FTBF/SquarePad-anode-capactive-readout/(list of files, cad)

Other CAD files:
Design2_TwoBoardPogoPin/Sch_ALL.dwg
