FTBF/SquarePad-anode-capactive-readout/Design1_SignleBoard/fab_instructions_square.docx

Fabrication notes for pad_64_in

(Square Anodes version 2)

Designer contact: Jacky Li, jackymengyangli@uchicago.edu

Board stack info: 6-layer board, 6 mm board,

The layers are organized as

i. Cu_F ---- Signal (L1)
ii. Cu_ln1 ----Ground (L2)
iii. Cu_ln2 (empty plane) ---- Ground (L3)
iv. Cu_ln3 ---- Ground (L4)
v. Cu_ln4 ---- Signal (L5)
vi. Cu_B ---- Ground (L6)

We have traces on Cu_F and Cu_ln4, they need to be 50 ohms impedance, including vias that connect the traces between these planes.

For traces on Cu_F, now you can couple it to Cu_ln1 to make it 50 ohms. Please make the distances between Cu_F and Cu_ln3 as far as possible.

I have adjusted the width of the vias, now they are >0.7mm.
