FTBF/SquarePad-anode-capactive-readout/Design2_TwoBoardPogoPin/Board1 - Pad and Pogo Pin/fab_instructions_Board1.docx

## Fabrication notes for <Board 1 – Pad and Pogo Pin>

Designer contact: Jacky Li, jackymengyangli@uchicago.edu

Board Stack Info: 2 layer board, 1.6 mm thickness, 1/1 oz Cu. Size 9.65 * 11.79 in.

No impedance control needed on this board.
