FTBF/SquarePad-anode-capactive-readout/Design2_TwoBoardPogoPin/Board2 - Housing and Samtech/fab_instructions_Board2.docx

## Fabrication notes for <Board 2 – Housing and Samtech>

Designer contact: Jacky Li, jackymengyangli@uchicago.edu

Board Stack Info: 4 layer board, 1.6 mm thickness, 1/1 oz Cu. Size 9.65 * 11.79 in.

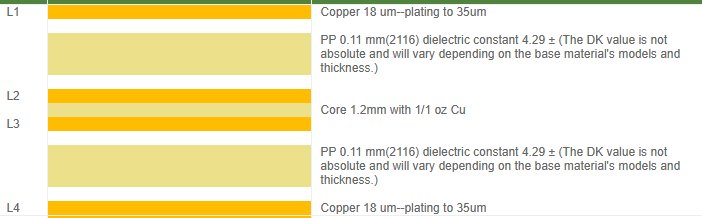
[picture p5: figure]

There are traces on L4, they couple to L3. We want impedance control on these to be 50 ohms.
