FTBF/SquarePad-anode-capactive-readout/Design2_TwoBoardPogoPin/Board1 - Pad and Pogo Pin/Kicad Files/Board1_Pad_PogoPin.kicad_pcb

## KiCad design Design2_TwoBoardPogoPin/Board1 - Pad and Pogo Pin/Kicad Files/Board1_Pad_PogoPin.kicad_pcb (2023-05-22)

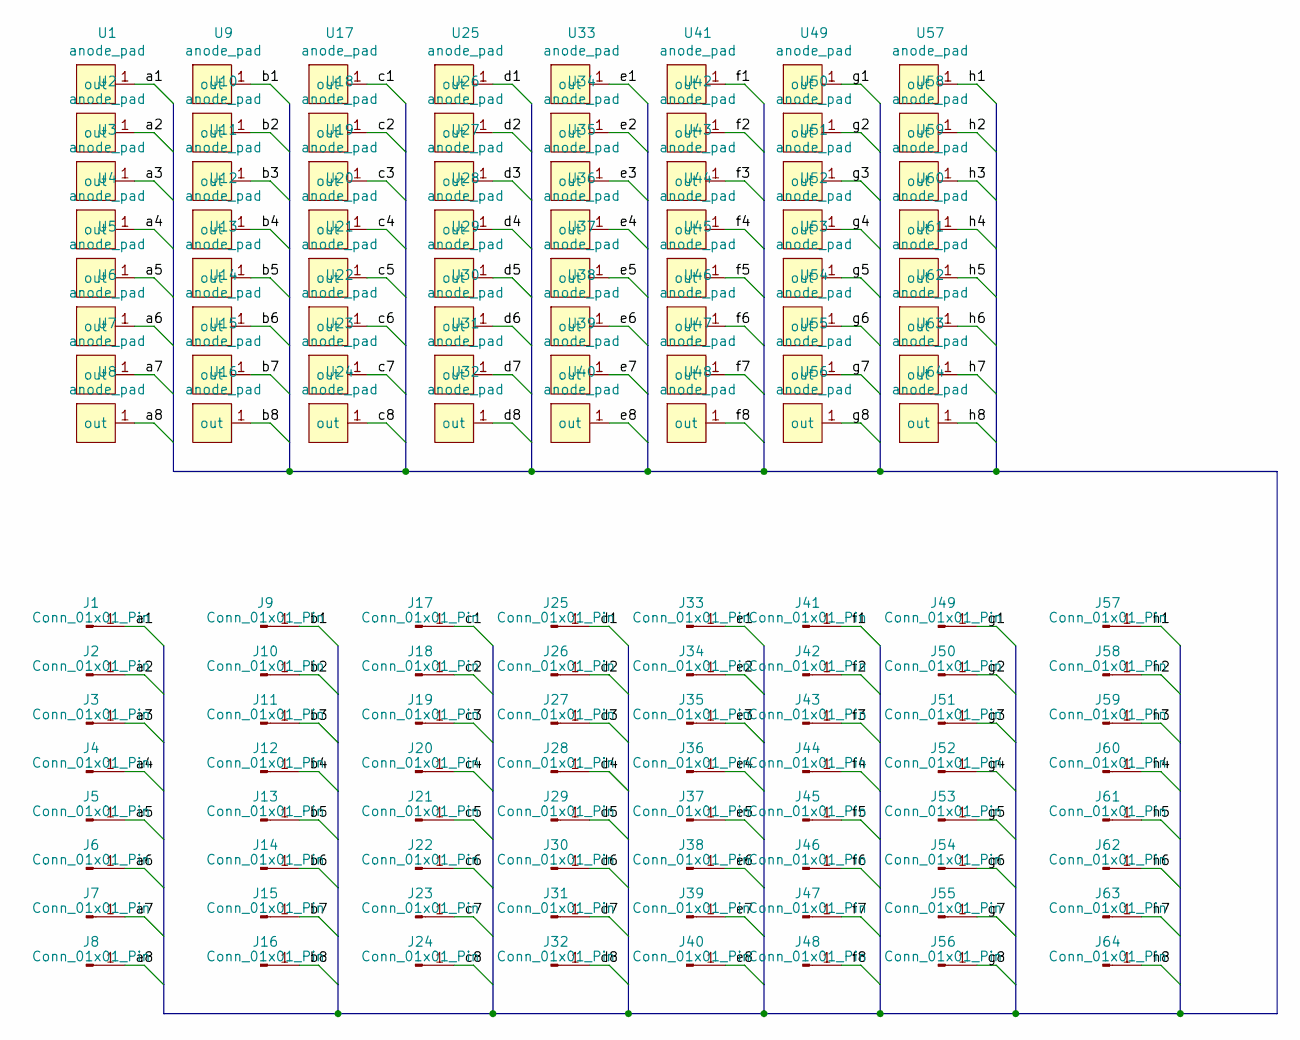
[picture p6: schematic Board1_Pad_PogoPin.kicad_sch]

Parts:
J1, J2, J3, J4, J5, J6, J7, J8, J9, J10, J11, J12, J13, J14, J15, J16, J17, J18, J19, J20, J21, J22, J23, J24, J25, J26, J27, J28, J29, J30, J31, J32, J33, J34, J35, J36, J37, J38, J39, J40, J41, J42, J43, J44, J45, J46, J47, J48, J49, J50, J51, J52, J53, J54, J55, J56, J57, J58, J59, J60, J61, J62, J63, J64: Conn_01x01_Pin; PogoPinWithTail
U1, U2, U3, U4, U5, U6, U7, U8, U9, U10, U11, U12, U13, U14, U15, U16, U17, U18, U19, U20, U21, U22, U23, U24, U25, U26, U27, U28, U29, U30, U31, U32, U33, U34, U35, U36, U37, U38, U39, U40, U41, U42, U43, U44, U45, U46, U47, U48, U49, U50, U51, U52, U53, U54, U55, U56, U57, U58, U59, U60, U61, U62, U63, U64: anode_pad; anode_square_pad_no_hole

Connections:
/a1: J1.1, U1.1 (out)
/a2: J2.1, U2.1 (out)
/a3: J3.1, U3.1 (out)
/a4: J4.1, U4.1 (out)
/a5: J5.1, U5.1 (out)
/a6: J6.1, U6.1 (out)
/a7: J7.1, U7.1 (out)
/a8: J8.1, U8.1 (out)
/b1: J9.1, U9.1 (out)
/b2: J10.1, U10.1 (out)
/b3: J11.1, U11.1 (out)
/b4: J12.1, U12.1 (out)
/b5: J13.1, U13.1 (out)
/b6: J14.1, U14.1 (out)
/b7: J15.1, U15.1 (out)
/b8: J16.1, U16.1 (out)
/c1: J17.1, U17.1 (out)
/c2: J18.1, U18.1 (out)
/c3: J19.1, U19.1 (out)
/c4: J20.1, U20.1 (out)
/c5: J21.1, U21.1 (out)
/c6: J22.1, U22.1 (out)
/c7: J23.1, U23.1 (out)
/c8: J24.1, U24.1 (out)
/d1: J25.1, U25.1 (out)
/d2: J26.1, U26.1 (out)
/d3: J27.1, U27.1 (out)
/d4: J28.1, U28.1 (out)
/d5: J29.1, U29.1 (out)
/d6: J30.1, U30.1 (out)
/d7: J31.1, U31.1 (out)
/d8: J32.1, U32.1 (out)
/e1: J33.1, U33.1 (out)
/e2: J34.1, U34.1 (out)
/e3: J35.1, U35.1 (out)
/e4: J36.1, U36.1 (out)
/e5: J37.1, U37.1 (out)
/e6: J38.1, U38.1 (out)
/e7: J39.1, U39.1 (out)
/e8: J40.1, U40.1 (out)
/f1: J41.1, U41.1 (out)
/f2: J42.1, U42.1 (out)
/f3: J43.1, U43.1 (out)
/f4: J44.1, U44.1 (out)
/f5: J45.1, U45.1 (out)
/f6: J46.1, U46.1 (out)
/f7: J47.1, U47.1 (out)
/f8: J48.1, U48.1 (out)
/g1: J49.1, U49.1 (out)
/g2: J50.1, U50.1 (out)
/g3: J51.1, U51.1 (out)
/g4: J52.1, U52.1 (out)
/g5: J53.1, U53.1 (out)
/g6: J54.1, U54.1 (out)
/g7: J55.1, U55.1 (out)
/g8: J56.1, U56.1 (out)
/h1: J57.1, U57.1 (out)
/h2: J58.1, U58.1 (out)
/h3: J59.1, U59.1 (out)
/h4: J60.1, U60.1 (out)
/h5: J61.1, U61.1 (out)
/h6: J62.1, U62.1 (out)
/h7: J63.1, U63.1 (out)
/h8: J64.1, U64.1 (out)

Board: 2 copper layers, 128 parts (64 on the bottom side), 64 nets, no tracks yet.
