FTBF/SquarePad-anode-capactive-readout/Design1_SignleBoard/kicad_project/pad_64in.kicad_pcb

## KiCad design Design1_SignleBoard/kicad_project/pad_64in.kicad_pcb (2023-03-02)

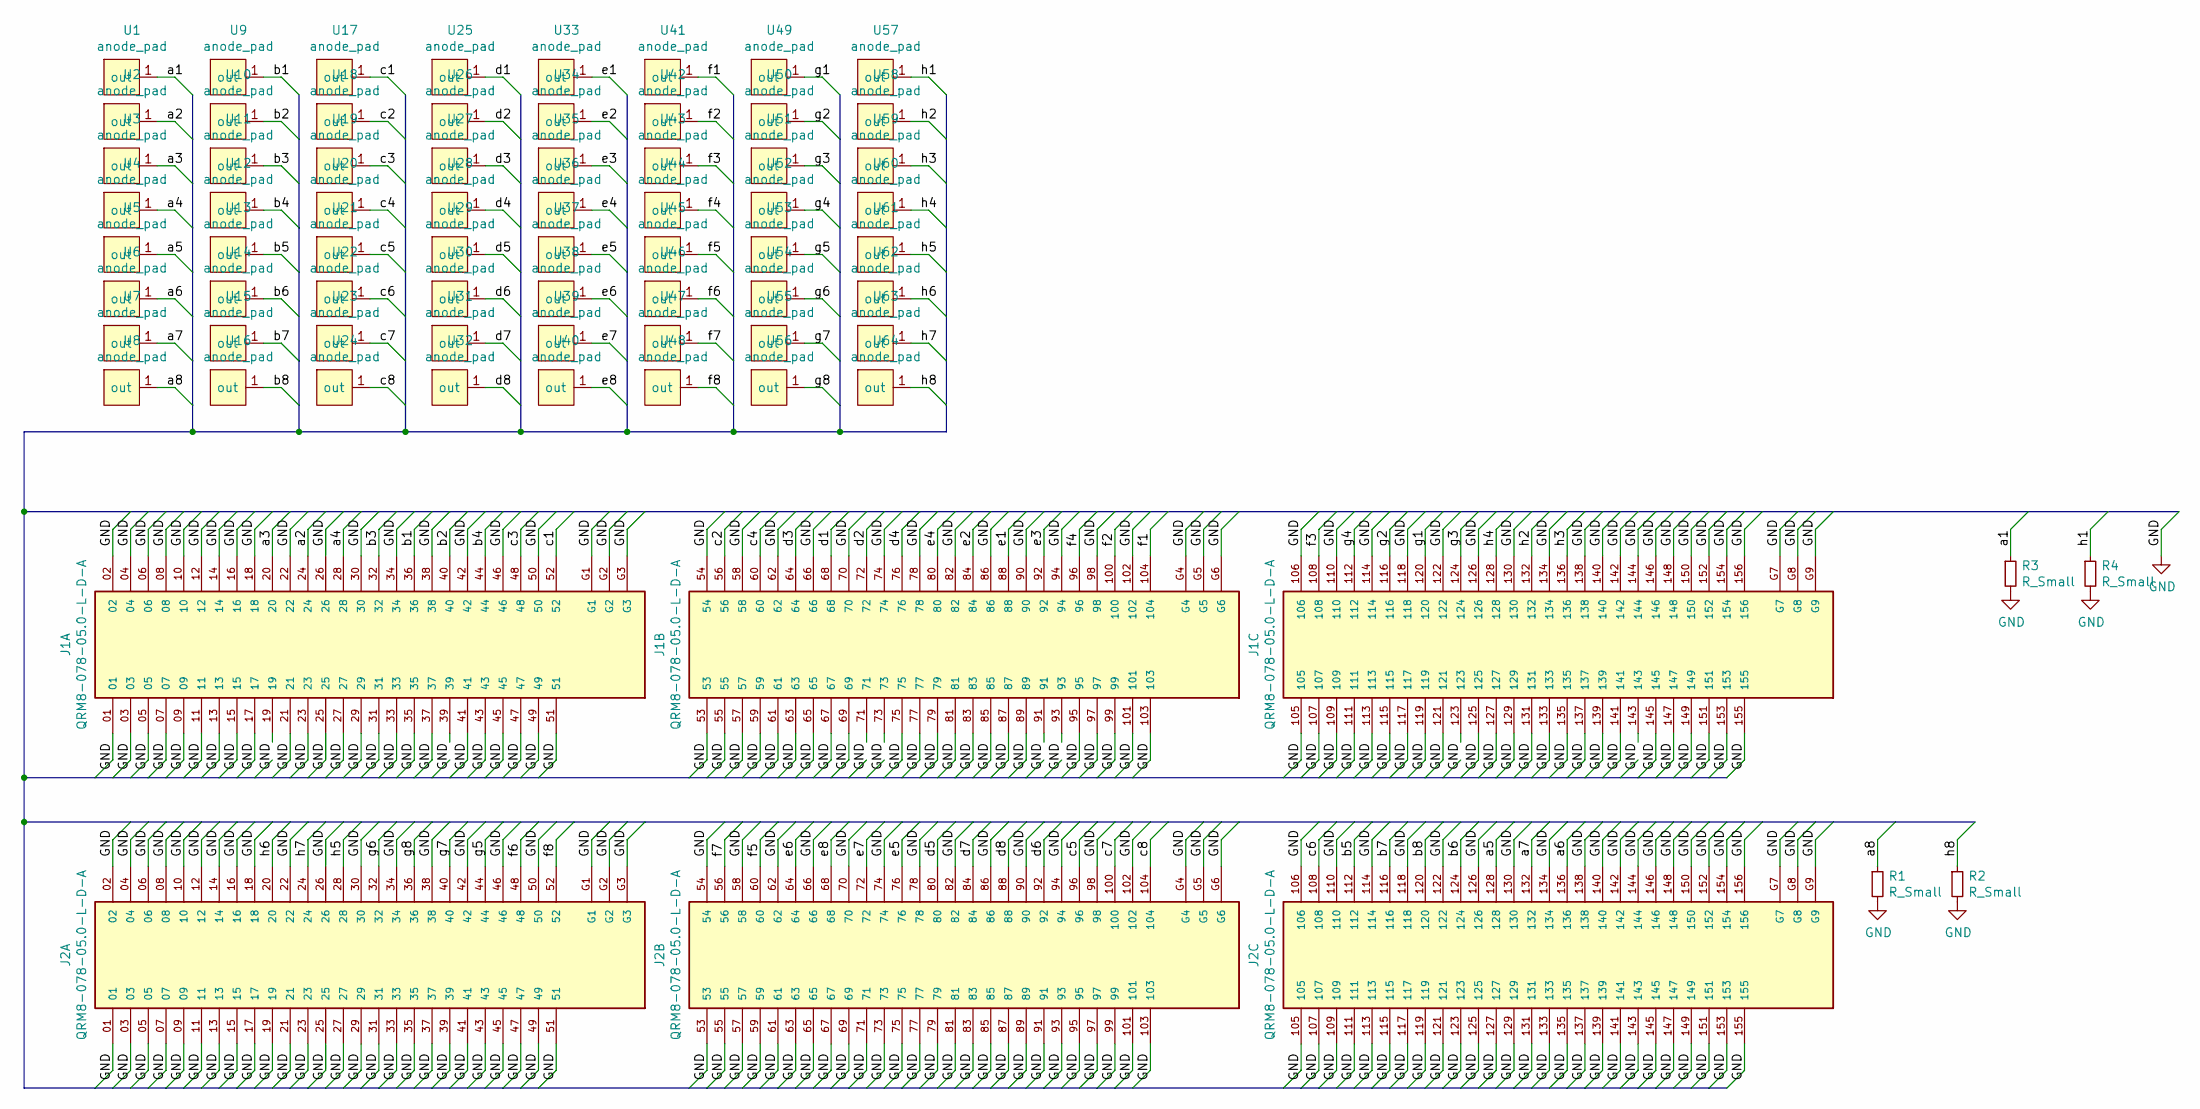
[picture p10: schematic pad_64in.kicad_sch]

Parts:
J1, J2: QRM8-078-05.0-L-D-A; SAMTEC_QRM8-078-05.0-L-D-A
R1, R2, R3, R4: R_Small; R_0805_2012Metric_Pad1.15x1.40mm_HandSolder
U1, U2, U3, U4, U5, U6, U7, U8, U9, U10, U11, U12, U13, U14, U15, U16, U17, U18, U19, U20, U21, U22, U23, U24, U25, U26, U27, U28, U29, U30, U31, U32, U33, U34, U35, U36, U37, U38, U39, U40, U41, U42, U43, U44, U45, U46, U47, U48, U49, U50, U51, U52, U53, U54, U55, U56, U57, U58, U59, U60, U61, U62, U63, U64: anode_pad; anode_square_pad

Connections:
/a1: R3.1, U1.1
/a2: J1.24, U2.1
/a3: J1.20, U3.1
/a4: J1.28, U4.1
/a5: J2.128, U5.1
/a6: J2.136, U6.1
/a7: J2.132, U7.1
/a8: R1.1, U8.1
/b1: J1.36, U9.1
/b2: J1.40, U10.1
/b3: J1.32, U11.1
/b4: J1.44, U12.1
/b5: J2.112, U13.1
/b6: J2.124, U14.1
/b7: J2.116, U15.1
/b8: J2.120, U16.1
/c1: J1.52, U17.1
/c2: J1.56, U18.1
/c3: J1.48, U19.1
/c4: J1.60, U20.1
/c5: J2.96, U21.1
/c6: J2.108, U22.1
/c7: J2.100, U23.1
/c8: J2.104, U24.1
/d1: J1.68, U25.1
/d2: J1.72, U26.1
/d3: J1.64, U27.1
/d4: J1.76, U28.1
/d5: J2.80, U29.1
/d6: J2.92, U30.1
/d7: J2.84, U31.1
/d8: J2.88, U32.1
/e1: J1.88, U33.1
/e2: J1.84, U34.1
/e3: J1.92, U35.1
/e4: J1.80, U36.1
/e5: J2.76, U37.1
/e6: J2.64, U38.1
/e7: J2.72, U39.1
/e8: J2.68, U40.1
/f1: J1.104, U41.1
/f2: J1.100, U42.1
/f3: J1.108, U43.1
/f4: J1.96, U44.1
/f5: J2.60, U45.1
/f6: J2.48, U46.1
/f7: J2.56, U47.1
/f8: J2.52, U48.1
/g1: J1.120, U49.1
/g2: J1.116, U50.1
/g3: J1.124, U51.1
/g4: J1.112, U52.1
/g5: J2.44, U53.1
/g6: J2.32, U54.1
/g7: J2.40, U55.1
/g8: J2.36, U56.1
/h1: R4.1, U57.1
/h2: J1.132, U58.1
/h3: J1.136, U59.1
/h4: J1.128, U60.1
/h5: J2.28, U61.1
/h6: J2.20, U62.1
/h7: J2.24, U63.1
/h8: R2.1, U64.1
GND: J1.01, J1.02, J1.03, J1.04, J1.05, J1.06, J1.07, J1.08, J1.09, J1.10, J1.11, J1.12, J1.13, J1.14, J1.15, J1.16, J1.17, J1.18, J1.19, J1.21, J1.22, J1.23, J1.25, J1.26, J1.27, J1.29, J1.30, J1.31, J1.33, J1.34, J1.35, J1.37, J1.38, J1.39, J1.41, J1.42, J1.43, J1.45, J1.46, J1.47, J1.49, J1.50, J1.51, J1.53, J1.54, J1.55, J1.57, J1.58, J1.59, J1.61, J1.62, J1.63, J1.65, J1.66, J1.67, J1.69, J1.70, J1.71, J1.73, J1.74, J1.75, J1.77, J1.78, J1.79, J1.81, J1.82, J1.83, J1.85, J1.86, J1.87, J1.89, J1.90, J1.91, J1.93, J1.94, J1.95, J1.97, J1.98, J1.99, J1.101, J1.102, J1.103, J1.105, J1.106, J1.107, J1.109, J1.110, J1.111, J1.113, J1.114, J1.115, J1.117, J1.118, J1.119, J1.121, J1.122, J1.123, J1.125, J1.126, J1.127, J1.129, J1.130, J1.131, J1.133, J1.134, J1.135, J1.137, J1.138, J1.139, J1.140, J1.141, J1.142, J1.143, J1.144, J1.145, J1.146, J1.147, J1.148, J1.149, J1.150, J1.151, J1.152, J1.153, J1.154, J1.155, J1.156, J1.G1, J1.G2, J1.G3, J1.G4, J1.G5, J1.G6, J1.G7, J1.G8, J1.G9, J2.01, J2.02, J2.03, J2.04, J2.05, J2.06, J2.07, J2.08, J2.09, J2.10, J2.11, J2.12, J2.13, J2.14, J2.15, J2.16, J2.17, J2.18, J2.19, J2.21, J2.22, J2.23, J2.25, J2.26, J2.27, J2.29, J2.30, J2.31, J2.33, J2.34, J2.35, J2.37, J2.38, J2.39, J2.41, J2.42, J2.43, J2.45, J2.46, J2.47, J2.49, J2.50, J2.51, J2.53, J2.54, J2.55, J2.57, J2.58, J2.59, J2.61, J2.62, J2.63, J2.65, J2.66, J2.67, J2.69, J2.70, J2.71, J2.73, J2.74, J2.75, J2.77, J2.78, J2.79, J2.81, J2.82, J2.83, J2.85, J2.86, J2.87, J2.89, J2.90, J2.91, J2.93, J2.94, J2.95, J2.97, J2.98, J2.99, J2.101, J2.102, J2.103, J2.105, J2.106, J2.107, J2.109, J2.110, J2.111, J2.113, J2.114, J2.115, J2.117, J2.118, J2.119, J2.121, J2.122, J2.123, J2.125, J2.126, J2.127, J2.129, J2.130, J2.131, J2.133, J2.134, J2.135, J2.137, J2.138, J2.139, J2.140, J2.141, J2.142, J2.143, J2.144, J2.145, J2.146, J2.147, J2.148, J2.149, J2.150, J2.151, J2.152, J2.153, J2.154, J2.155, J2.156, J2.G1, J2.G2, J2.G3, J2.G4, J2.G5, J2.G6, J2.G7, J2.G8, J2.G9, R1.2, R2.2, R3.2, R4.2

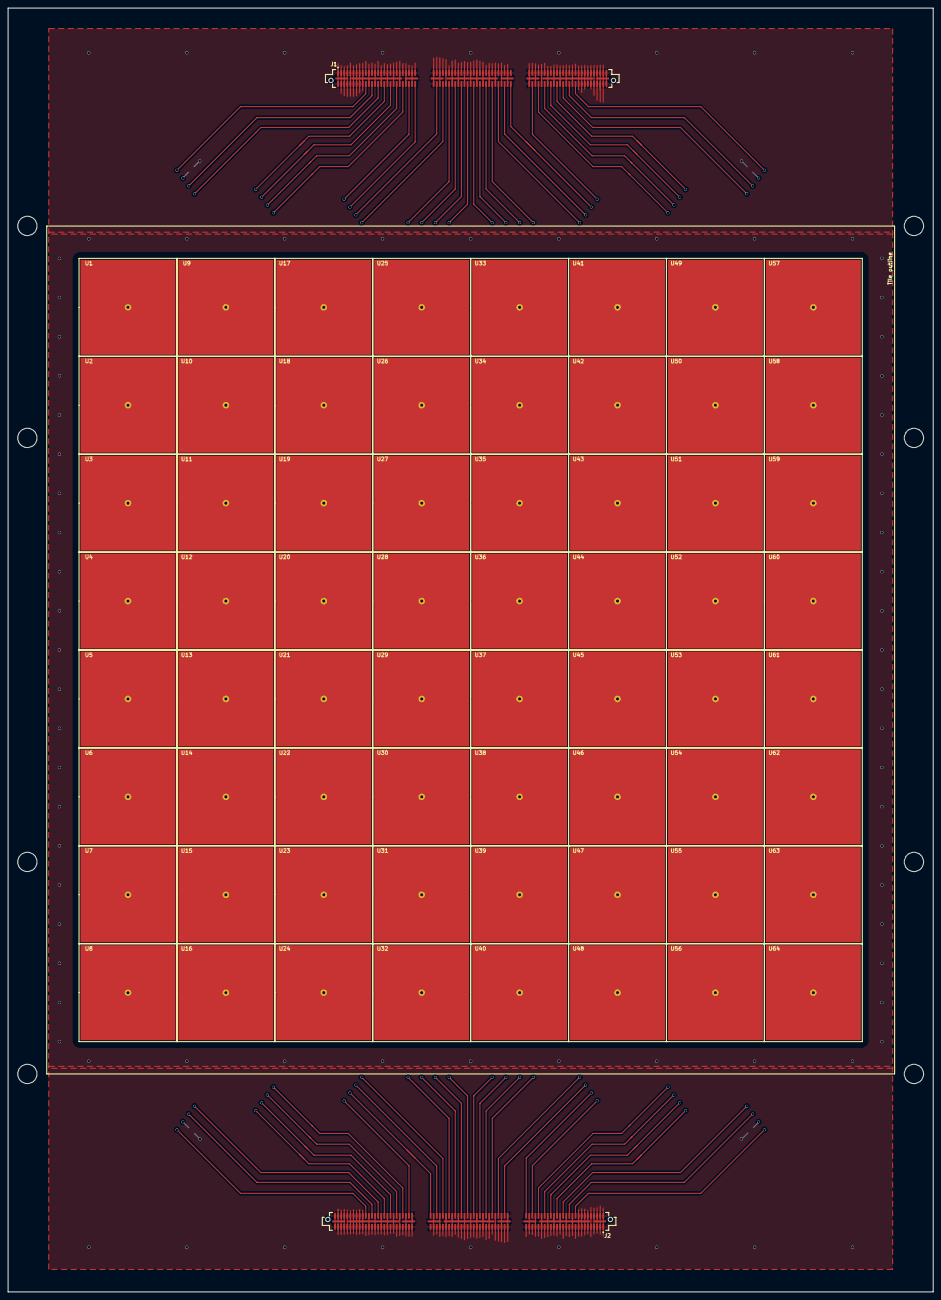
[picture p11: board pad_64in.kicad_pcb from above]

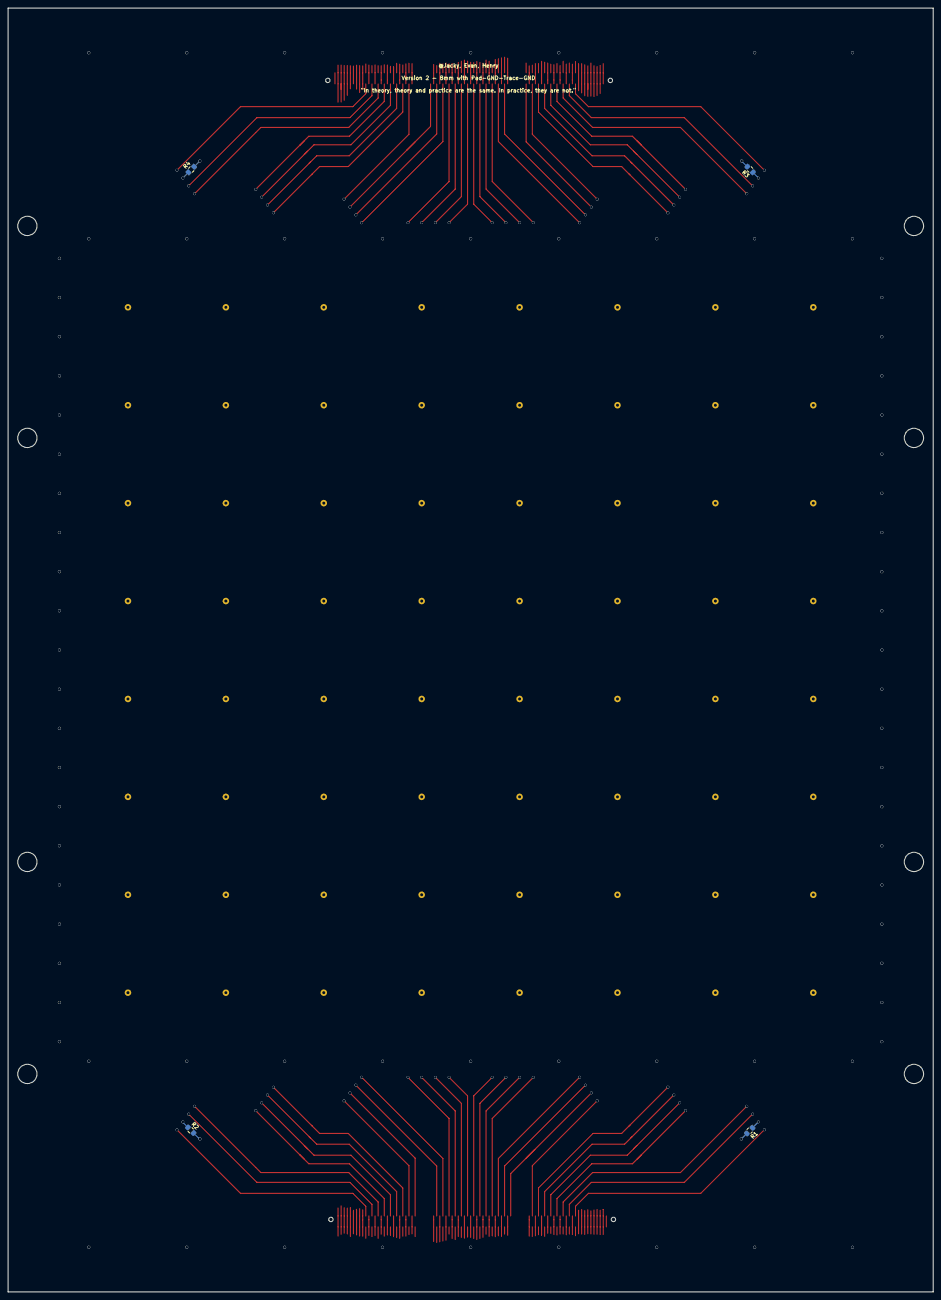
[picture p12: board pad_64in.kicad_pcb from below]

Board: 6 copper layers, 240.0 x 333.1 mm, 70 parts (4 on the bottom side), 65 nets.
