FTBF/SquarePad-anode-capactive-readout/(commit log)

2023-01-13 Still need to correct monting holes
    [pad_64in.kicad_pcb, pad_64in.sch]
2023-03-02 submiting design2
    [Board1_Pad_PogoPin.kicad_pcb, Board1_Pad_PogoPin.kicad_sch, PadPogoPin.kicad_sch, pad_64in.kicad_pcb, pad_64in.kicad_sch, pad_64in.sch]
2023-03-03 two boards finished
    [Board1_Pad_PogoPin.kicad_pcb, Board1_Pad_PogoPin.kicad_sch, Board2 - Housing and Samtech.kicad_pcb, Board2 - Housing and Samtech.kicad_sch]
2023-03-18 Finished two board design, waiting for review
    [Board1_Pad_PogoPin.kicad_pcb, Board2 - Housing and Samtech.kicad_pcb, Board2 - Housing and Samtech.kicad_sch, PadPogoPin.kicad_sch, pad_64in.kicad_pcb, pad_64in.kicad_sch, pad_64in.sch]
2023-03-19 update step files
    [Board1_Pad_PogoPin.step, Board2 - Housing and Samtech.kicad_pcb, Board2 - Housing and Samtech.step]
2023-05-12 May 12 update
    [Board1_Pad_PogoPin.kicad_pcb, Board1_Pad_PogoPin.step, Board2 - Housing and Samtech.kicad_pcb, Board2 - Housing and Samtech.step, Sch_ALL.dwg]
2023-05-22 ready for fab
    [Board1_Pad_PogoPin-B_Cu.gbr, Board1_Pad_PogoPin-B_Mask.gbr, Board1_Pad_PogoPin-B_Paste.gbr, Board1_Pad_PogoPin-B_Silkscreen.gbr, Board1_Pad_PogoPin-Edge_Cuts.gbr, Board1_Pad_PogoPin-F_Cu.gbr, Board1_Pad_PogoPin-F_Mask.gbr, Board1_Pad_PogoPin-F_Paste.gbr]
